HackerHotel/PCB/README.md

# PCB

This repository hosts the board files for the HackerHotel 2019 badge.

This is an EAGLE 8 (?) project. It should be possible to import it in
[KiCad](https://kicad-pcb.org)
