HackerHotel/PCB/assembly/Hackerhotel_BOM.xls

HackerHotel 2019 BOM
Contact: bas@knutselaar.net
Rev 1
Qty per PCB | Type | Device | Value | Package | Parts
1 | Display socket | 68712414022 | 24 pos FPC 0.5mm SMD right angle | 68712414022 | X1
4 | Schottky diode | BAT20JFILM | NSVR0320MW2T1G | SOD-323 | D3, D7, D8, D9
20 | Capacitor | C0603 | 100n | C0603 | C1, C2, C3, C4, C5, C6, C8, C10, C11, C14, C16, C22, C23, C27, C28, C29, C37, C44, C45, C54
15 | Capacitor | C0603 | 1µ | C0603 | C19, C21, C25, C32, C33, C35, C36, C38, C39, C40, C42, C46, C49, C50, C53
11 | Capacitor | C-EUC0805 | 4.7µ / 16V | C0805 | C9, C13, C15, C17, C18, C20, C24, C26, C30, C34, C43
1 | ESD Suppressor | DIODE-SCHOTTKY-PMEG4005EJ | SD05-7 | SOD-323 | D1
1 | Inductor | INDUCTOR1210 | 47µ | L1210 | L1
1 | Battery connector | JST S3B-PH-SM4-TB | JST S3B-PH-SM4-TB | JST-PH3 | X4
1 | Voltage regulator | AP2114H-3.3TRG1 | AP2114H-3.3TRG1 | SOT233-3 | IC2
1 | Red LED | LED0603 | RED | LED-0603 | D5
1 | Yellow LED | LED0603 | Yellow | LED-0603 | D4
1 | Green LED | LED0603 | green | LED-0603 | D6
1 | USB connector | MOLEX-47346-0001 | MOLEX-47346-0001 | MOLEX-47364-0001 | USB1
2 | N-channel MOSFET | MOSFET-NCHANNEL2N7002PW | SI1304 BDL | SOT323 | Q5, Q6
2 | P-channel MOSFET | MOSFET-PCHANNEL |  | SOT23-3 | T1, T2
1 | Touch IC | MPR121QR2 | MPR121QR2 | QFN40P300X300X60-20N | U1
1 | Sound chip | PCM5102A | PCM5102A | TSSOP 20pins | U3
1 | 3.5mm stereo jack | PJ-313D | PJ-313D | PJ-313D | J1
2 | PTC Fuse | PTCSMD | 1A | PTC-1206 | F1, F2
1 | Resistor | R1206 | 0.27Ω 1/4W | R1206 | R30
2 | Resistor | R0603 | 1.2k | R0603 | R29, R35
4 | Resistor | R0603 | 100k | R0603 | R1, R6, R20, R36
11 | Resistor | R0603 | 10k | R0603 | R2, R4, R5, R9, R10, R13, R15, R16, R18, R22, R32
3 | Resistor | R0603 | 1k | R0603 | R3, R12, R14
2 | Resistor | R0603 | 220k | R0603 | R7, R21
1 | Resistor | R0603 | 2.7Ω | R0603 | R19
2 | Resistor | R0603 | 4k7 | R0603 | R23, R24
1 | Resistor | R0603 | 75k 1% | R0603 | R37
2 | Tactile switch | SWITCH-MOMENTARY-2SMD | SWITCH-MOMENTARY-2SMD | TACTILE-SWITCH-SMD | S1, S2
1 | Battery charger IC | TP4056 | TP4056 | SOP-8 | IC4
3 | NPN transistor | TRANSISTOR_NPNMMBT2222A | MMBT2222A | SOT23-3 | Q1, Q3, Q4
Inbound from Sillicon Labs (do not buy!)
1 | USB-Serial IC | CP210X_USB_UART | CP210X_USB_UART | MLP28 | IC1
Optional depending on budget for mounting
1 | CONN HEADER PH TOP 4POS 2MM SMD | B4B-PH-SM4-TB | B4B-PH-SM4-TB | JST_B4B-PH-SM4-TB | P1
6 | SK2812 RGBW pixels | SK6812 | SK6812-RGBW | 5050 | D100, D101, D102, D103, D104, D105
Optional depending on budget, do not mount
1 | IR LED
1 | IR Receiver | TL1838 VS1838B 1838 38Khz
Do not buy/mount
1 | ESP module | ESP32WROVER32 | ESP32WROVER32 | XCVR_ESP32-WROVER-I | U2
