HackerHotel/PCB/hh2019_proto.brd

## EAGLE design hh2019_proto.brd (2018-12-31)

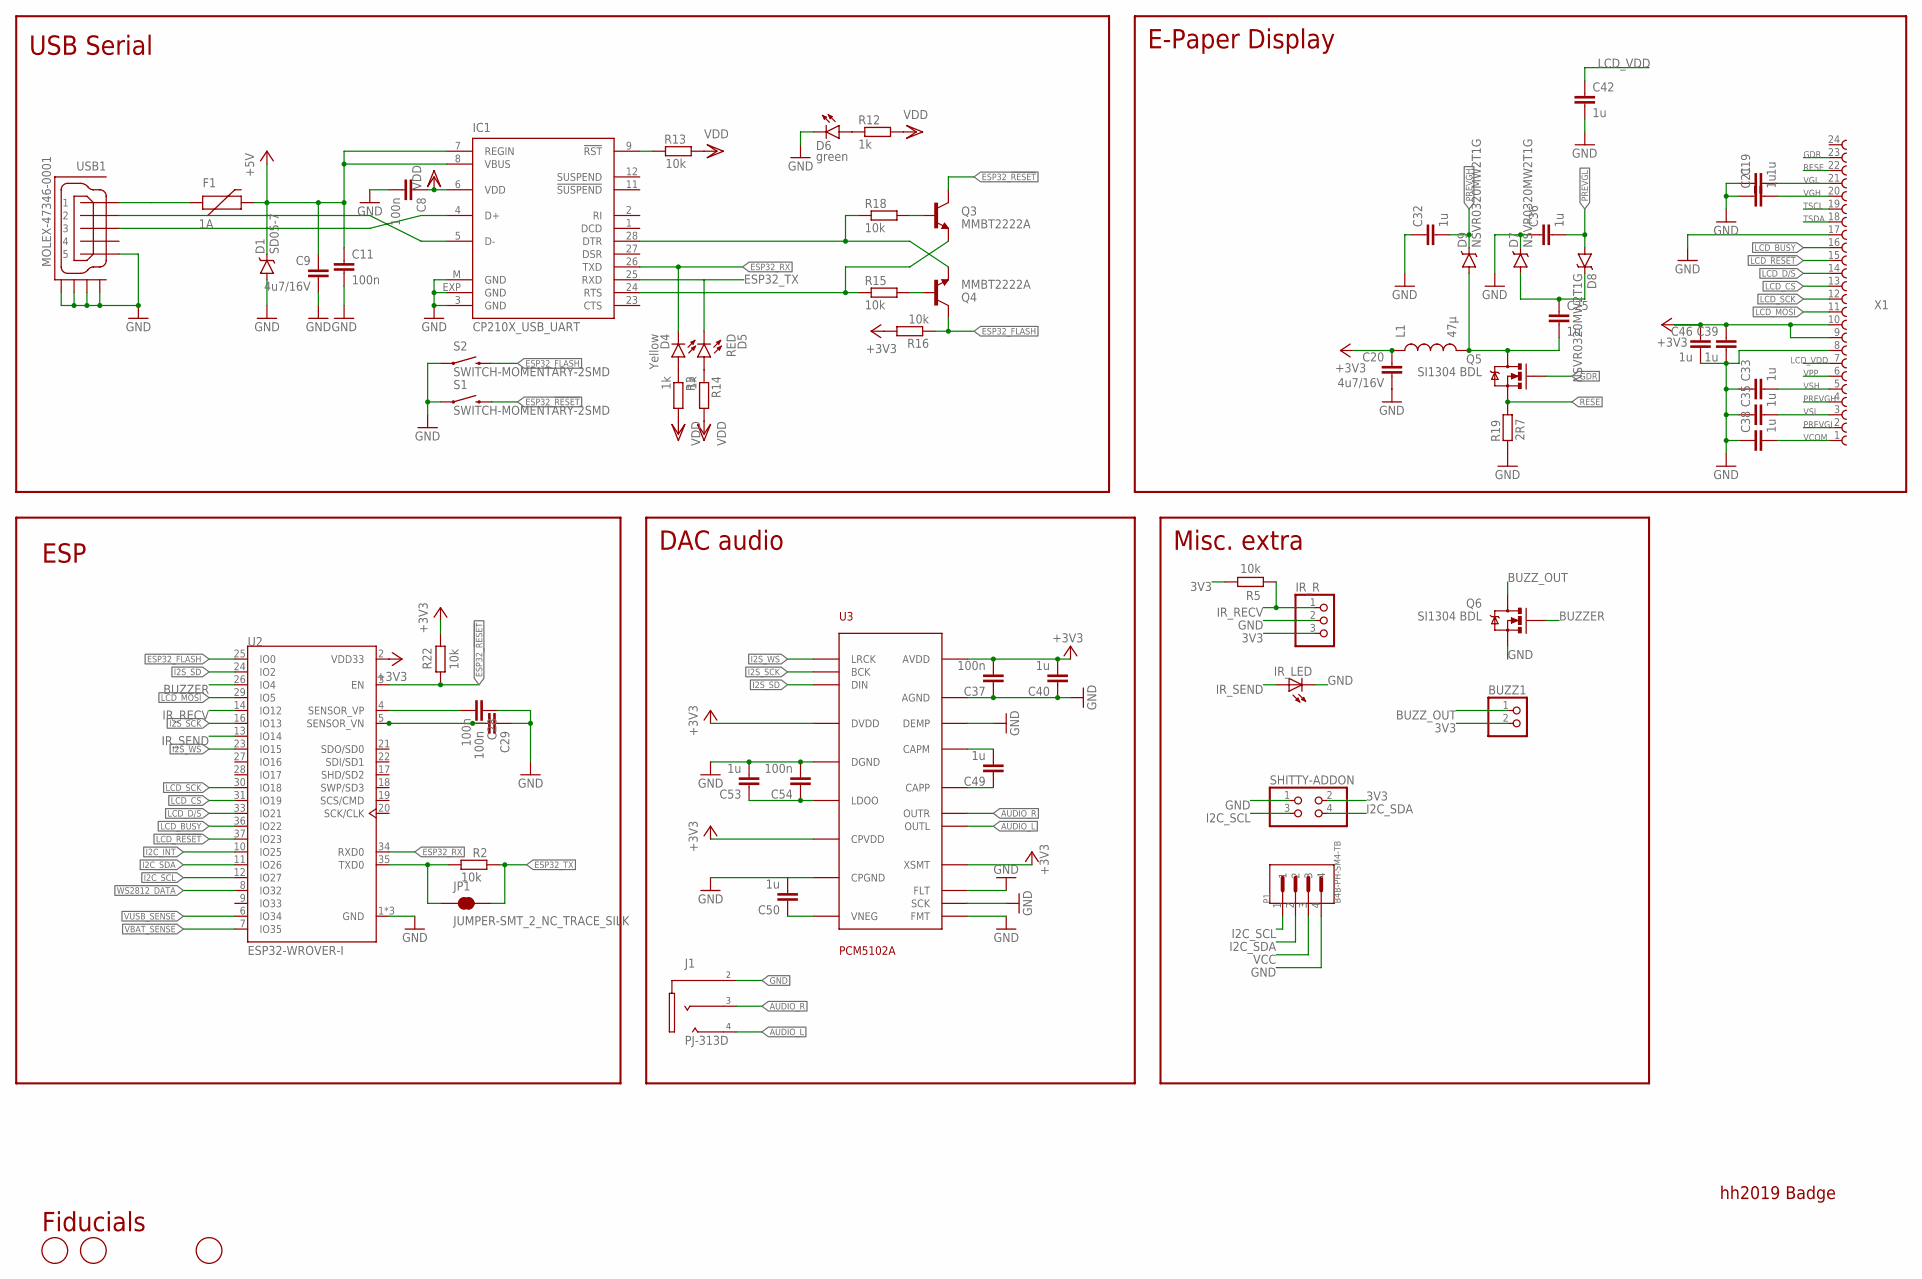
[picture p1: schematic hh2019_proto.sch, sheet 1]

Parts:
BUZZ1: PINHD-1X2; 1X02
C8, C11, C28, C29: 100n; C0603-DASHES; PARTNO GRM188R71H104KA93D
C9, C20: 4u7/16V; C0805; PARTNO GRM21BR61C475KA88K
C19, C21, C25, C32, C33, C35, C36, C38, C39, C42, C46: 1u; C0603-DASHES; PARTNO GRM188R61E105KA12D
C37, C54: 100n; C0603
C40, C49, C50, C53: 1u; C0603
D1: SD05-7; SOD-323; PARTNO SD05-7
D4: Yellow; LED-0603
D5: RED; LED-0603
D6: green; LED-0603
D7, D8, D9: NSVR0320MW2T1G; SOD-323; PARTNO BAT20JFILM
F1: 1A; PTC-1206
FD1, FD4, FD5: FIDUCIAL; FIDUCIAL_1MM; PARTNO NAP
IC1: CP210X_USB_UART; MLP28; PARTNO CP2102-GMR
IR_LED: LED5MM
IR_R: PINHD-1X3; 1X03
J1: PJ-313D
JP1: JUMPER-SMT_2_NC_TRACE_SILK; SMT-JUMPER_2_NC_TRACE_SILK
L1: 47µ; 1210; PARTNO NLCV32T-220K-EF
P1: B4B-PH-SM4-TB; JST_B4B-PH-SM4-TB
Q3, Q4: MMBT2222A; SOT23-3; PARTNO BC817-25,215
Q5, Q6: SI1304 BDL; SOT323; PARTNO SI1308EDL-T1-GE3
R2, R5, R13, R15, R16, R18, R22: 10k; R0603-DASHES; PARTNO ERJ-3GEYJ103V
R3, R12, R14: 1k; R0603-DASHES; PARTNO ERJ-3GEYJ102V
R19: 2R7; R0603-DASHES; PARTNO ERJ-3GEYJ5R1V
S1, S2: SWITCH-MOMENTARY-2SMD; TACTILE-SWITCH-SMD; PARTNO SKQGABE010
SHITTY-ADDON: PINHD-2X2; 2X02
U2: ESP32-WROVER-I; XCVR_ESP32-WROVER-I
U3: PCM5102A
USB1: MOLEX-47346-0001; MOLEX-47364-0001; PARTNO 10118192-0001LF
X1: 68712414022; PARTNO 68712414022

Connections:
3V3: BUZZ1.2, C20.1, C37.2, C39.1, C40.2, C46.1, IR_R.3, L1.1, R5.1, R16.2, R22.1, SHITTY-ADDON.2, U2.2 (VDD33), U3.P$1 (CPVDD), U3.P$8 (AVDD), U3.P$17 (XSMT), U3.P$20 (DVDD), X1.9, X1.10; also elsewhere on the board
+5V: C9.1, C11.1, D1.C, F1.2, IC1.7 (REGIN), IC1.8 (VBUS); also elsewhere on the board
AUDIO_L: J1.4_1 (4), J1.4_2 (4), U3.P$6 (OUTL)
AUDIO_R: J1.3_1 (3), J1.3_2 (3), U3.P$7 (OUTR)
BUZZER: Q6.1 (G), U2.26 (IO4)
BUZZ_OUT: BUZZ1.1, Q6.3 (D)
CAPM: C49.2, U3.P$4 (CAPM)
CAPP: C49.1, U3.P$2 (CAPP)
ESP32_!RESET: Q3.3 (C), R22.2, S1.3 (2), U2.3 (EN)
ESP32_FLASH: Q4.3 (C), R16.1, S2.3 (2), U2.25 (IO0)
ESP32_RX: D4.C, IC1.26 (TXD), U2.34 (RXD0)
ESP32_TX: D5.C, IC1.25 (RXD), JP1.2, R2.1
ESP32_TX_PRE: JP1.1, R2.2, U2.35 (TXD0)
GDR: Q5.1 (G), X1.23
GND: C8.2, C9.2, C11.2, C19.1, C20.2, C21.1, C28.1, C29.1, C32.1, C33.1, C35.1, C36.1, C37.1, C38.1, C39.2, C40.1, C42.2, C46.2, C50.2, C53.2, C54.2, D1.A, D6.C, D7.C, IC1.3 (GND), IC1.EXP (GND), IC1.M (GND), IR_LED.K (C), IR_R.2, J1.2_1 (2), J1.2_2 (2), P1.4, Q6.2 (S), R19.2, S1.1, S2.1, SHITTY-ADDON.1, U2.1 (GND), U2.15 (GND), U2.38 (GND), U3.P$3 (CPGND), U3.P$9 (AGND), U3.P$10 (DEMP), U3.P$11 (FLT), U3.P$12 (SCK), U3.P$16 (FMT), U3.P$19 (DGND), USB1.5, USB1.GND1, USB1.GND2, USB1.GND3, USB1.GND4, X1.8, X1.17; also elsewhere on the board
I2C_INT: U2.10 (IO25); also elsewhere on the board
I2C_SCL: P1.1, SHITTY-ADDON.3, U2.12 (IO27); also elsewhere on the board
I2C_SDA: P1.2, SHITTY-ADDON.4, U2.11 (IO26); also elsewhere on the board
I2S_SCK: U2.16 (IO13), U3.P$13 (BCK)
I2S_SD: U2.24 (IO2), U3.P$14 (DIN)
I2S_WS: U2.23 (IO15), U3.P$15 (LRCK)
IR_RECV: IR_R.1, R5.2, U2.14 (IO12)
IR_SEND: IR_LED.A, U2.13 (IO14)
LCD_!RESET: U2.37 (IO23), X1.15
LCD_BUSY: U2.36 (IO22), X1.16
LCD_CS: U2.31 (IO19), X1.13
LCD_D/!S: U2.33 (IO21), X1.14
LCD_MOSI: U2.29 (IO5), X1.11
LCD_SCK: U2.30 (IO18), X1.12
LCD_VDD: C42.1, X1.7
LDO0: C53.1, C54.1, U3.P$18 (LDOO)
unnamed: IC1.24 (RTS), Q3.2 (E), R15.1
unnamed: IC1.28 (DTR), Q4.2 (E), R18.1
unnamed: Q4.1 (B), R15.2
unnamed: Q3.1 (B), R18.2
unnamed: C25.1, D7.A, D8.C
unnamed: C25.2, D9.A, L1.2, Q5.3 (D)
unnamed: D6.A, R12.1
unnamed: D4.A, R3.1
unnamed: D5.A, R14.1
unnamed: F1.1, USB1.1
unnamed: C28.2, U2.4 (SENSOR_VP)
unnamed: C29.2, U2.5 (SENSOR_VN)
PREVGH: C32.2, D9.C, X1.4
PREVGL: C36.2, D8.A, X1.2
RESE: Q5.2 (S), R19.1, X1.22
RST: IC1.9 (!RST), R13.2
TSCL: X1.19
TSDA: X1.18
USB_DN_CON: IC1.5 (D-), USB1.2
USB_DP_CON: IC1.4 (D+), USB1.3
VBAT_SENSE: U2.7 (IO35); also elsewhere on the board
VCC: P1.3; also elsewhere on the board
VCOM: C38.2, X1.1
VDD: C8.1, IC1.6 (VDD), R3.2, R12.2, R13.1, R14.2
VGH: C21.2, X1.20
VGL: C19.2, X1.21
VNEG: C50.1, U3.P$5 (VNEG)
VPP: X1.6
VSH: C33.2, X1.5
VSL: C35.2, X1.3
VUSB_SENSE: U2.6 (IO34); also elsewhere on the board
WS2812_DATA: U2.8 (IO32); also elsewhere on the board

Notes on the sheet:
USB Serial
E-Paper Display
ESP
Fiducials
hh2019 Badge
DAC audio
Misc. extra

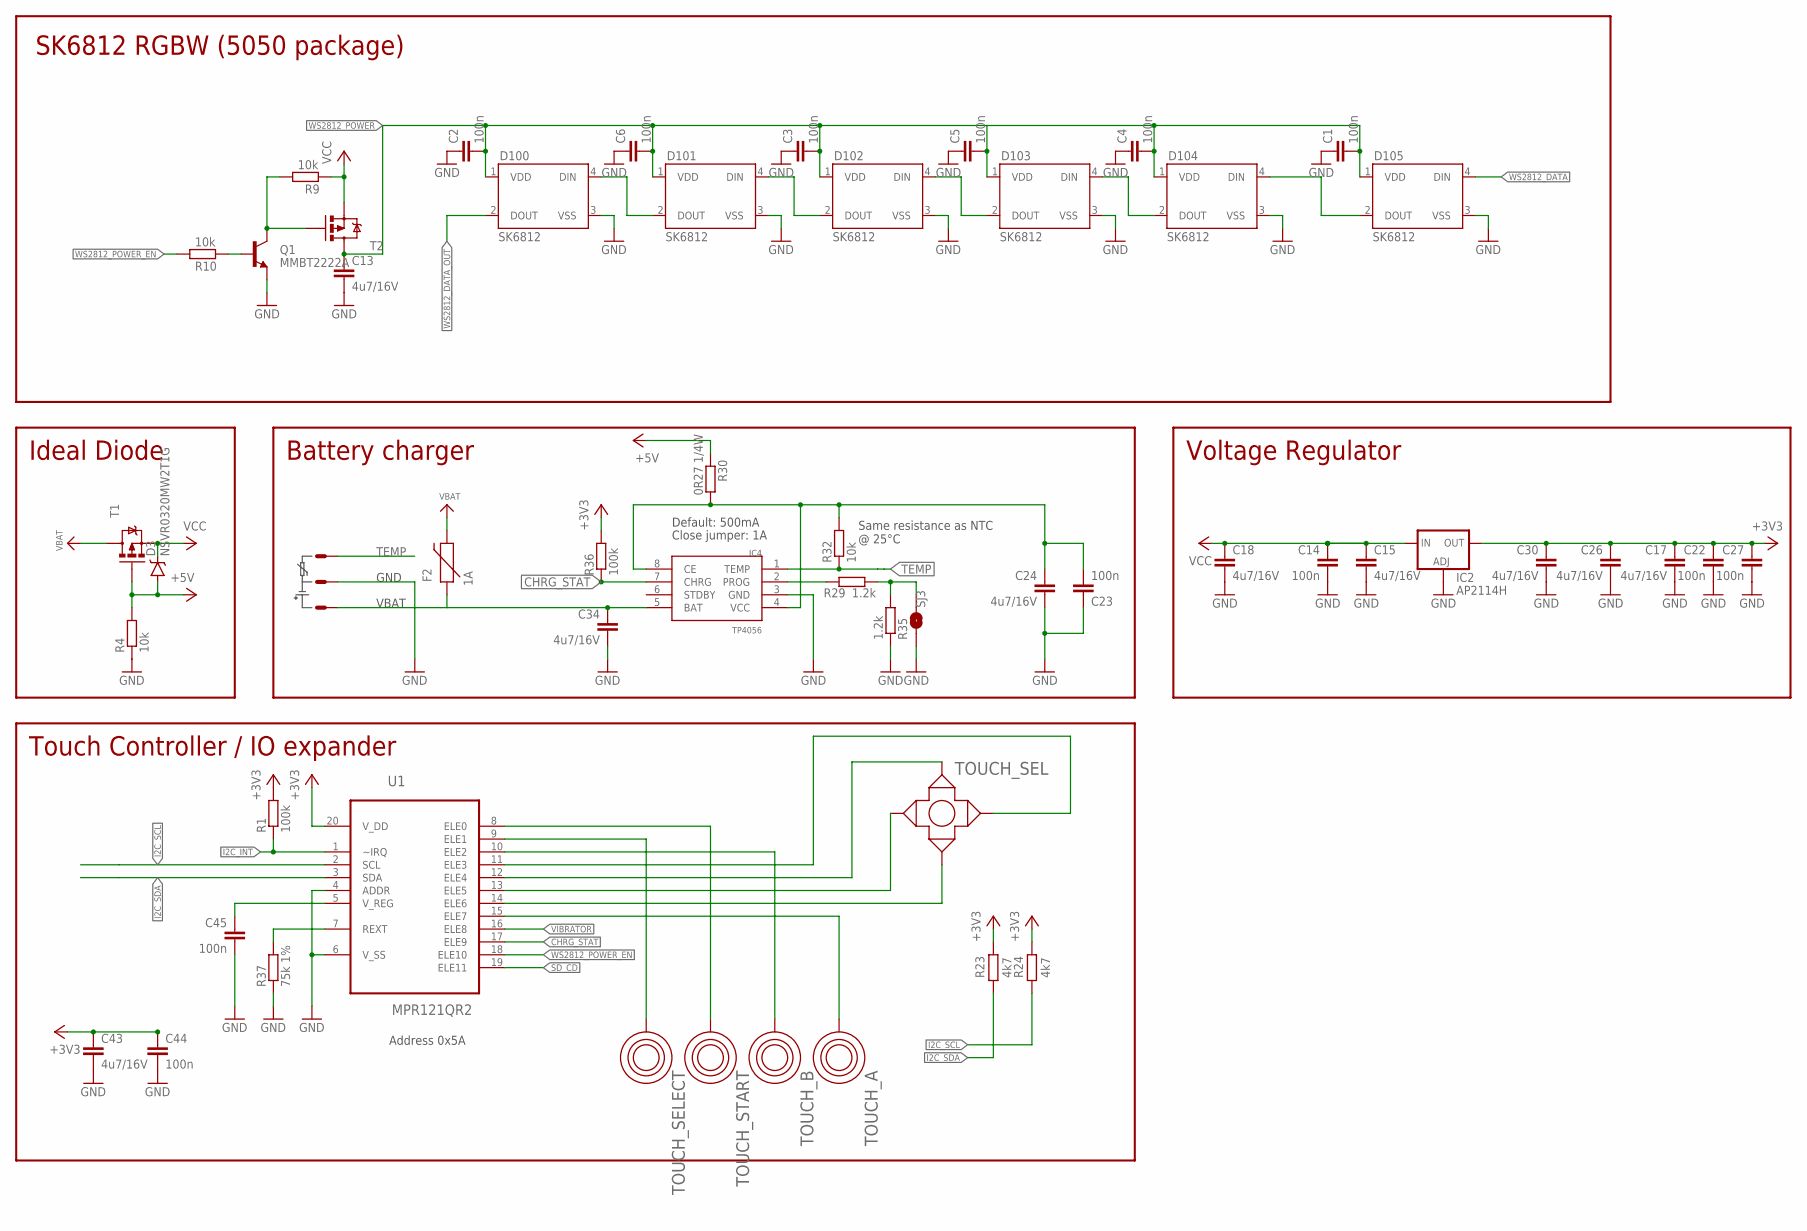
[picture p2: schematic hh2019_proto.sch, sheet 2]

Parts:
C1, C2, C3, C4, C5, C6, C14, C22, C23, C27, C44, C45: 100n; C0603-DASHES; PARTNO GRM188R71H104KA93D
C13, C15, C17, C18, C24, C26, C30, C34, C43: 4u7/16V; C0805; PARTNO GRM21BR61C475KA88K
D3: NSVR0320MW2T1G; SOD-323; PARTNO BAT20JFILM
D100, D101, D102, D103, D104, D105: SK6812; WS2812B; PARTNO SK6812
F2: 1A; PTC-1206
IC2: AP2114H; SOT223; PARTNO AP7215-33YG-13
IC4: TP4056; SOP-8
Q1: MMBT2222A; SOT23-3; PARTNO BC817-25,215
R1, R36: 100k; R0603-DASHES; PARTNO ERJ-3GEYJ104V
R4, R9, R10: 10k; R0603-DASHES; PARTNO ERJ-3GEYJ103V
R23, R24: 4k7; R0603-DASHES; PARTNO ERJ-3GEYJ103V
R29, R35: 1.2k; R0603-DASHES; PARTNO ERJ-3GEYJ222V
R30: 0R27 1/4W; R1206; PARTNO ERJ-3GEYJ154V
R32: 10k; R0603-DASHES; PARTNO ERJ-3GEYJ154V
R37: 75k 1%; R0603-DASHES; PARTNO ERJ-3GEYJ104V
SJ3: JUMPER-PAD-2-NOYES_SILK; PAD-JUMPER-2-NO_YES_SILK; PARTNO NAP
T1, T2: MOSFET-PCHANNEL; SOT23-3
TOUCH_A: TOUCHROUND; TOUCH_BUTTON; PARTNO NAP
TOUCH_B: TOUCHROUND; TOUCH_BUTTON; PARTNO NAP
TOUCH_SEL: TOUCH_CROSS; PARTNO NAP
TOUCH_SELECT: TOUCHSELECT; TOUCH_SELECT
TOUCH_START: TOUCHSELECT; TOUCH_SELECT
U1: MPR121QR2; QFN40P300X300X60-20N
X4: JST-PH3

Connections:
3V3: C17.1, C22.1, C26.1, C27.1, C30.1, C43.1, C44.1, IC2.4 (OUT), R1.2, R23.1, R24.1, R36.2, U1.20 (V_DD); also elsewhere on the board
+5V: D3.A, R4.2, R30.1, T1.1 (G); also elsewhere on the board
BAT: C34.1, F2.1, IC4.5 (BAT), X4.3
CE: C23.2, C24.1, IC4.4 (VCC), IC4.8 (CE), R30.2, R32.2
CHRG_STAT: IC4.7 (CHRG), R36.1, U1.17 (ELE9)
ELE0: TOUCH_START.P$1, U1.8 (ELE0)
ELE1: TOUCH_SELECT.P$1, U1.9 (ELE1)
ELE2: TOUCH_B.P$1, U1.10 (ELE2)
ELE3: TOUCH_SEL.R (RIGHT), U1.11 (ELE3)
ELE4: TOUCH_SEL.UP, U1.12 (ELE4)
ELE5: TOUCH_SEL.L (LEFT), U1.13 (ELE5)
ELE6: TOUCH_SEL.D (DOWN), U1.14 (ELE6)
ELE7: TOUCH_A.P$1, U1.15 (ELE7)
GND: C1.1, C2.1, C3.1, C4.1, C5.1, C6.1, C13.2, C14.2, C15.2, C17.2, C18.2, C22.2, C23.1, C24.2, C26.2, C27.2, C30.2, C34.2, C43.2, C44.2, C45.2, D100.3 (VSS), D101.3 (VSS), D102.3 (VSS), D103.3 (VSS), D104.3 (VSS), D105.3 (VSS), IC2.1 (ADJ), IC4.3 (GND), Q1.2 (E), R4.1, R35.2, R37.1, SJ3.1, U1.4 (ADDR), U1.6 (V_SS), X4.2; also elsewhere on the board
I2C_INT: R1.1, U1.1 (~IRQ); also elsewhere on the board
I2C_SCL: R24.2, U1.2 (SCL); also elsewhere on the board
I2C_SDA: R23.2, U1.3 (SDA); also elsewhere on the board
unnamed: D100.4 (DIN), D101.2 (DOUT)
unnamed: D103.4 (DIN), D104.2 (DOUT)
unnamed: D104.4 (DIN), D105.2 (DOUT)
unnamed: R29.2, R35.1, SJ3.2
unnamed: D101.4 (DIN), D102.2 (DOUT)
unnamed: C45.1, U1.5 (V_REG)
unnamed: R37.2, U1.7 (REXT)
unnamed: D102.4 (DIN), D103.2 (DOUT)
unnamed: Q1.1 (B), R10.2
unnamed: Q1.3 (C), R9.1, T2.1 (G)
PROG: IC4.2 (PROG), R29.1
SD_CD: U1.19 (ELE11)
TEMP: IC4.1 (TEMP), R32.1, X4.1
VBAT: F2.2, T1.3 (D); also elsewhere on the board
VCC: C14.1, C15.1, C18.1, D3.C, IC2.3 (IN), R9.2, T1.2 (S), T2.2 (S); also elsewhere on the board
VIBRATOR: U1.16 (ELE8)
WS2812_DATA: D105.4 (DIN); also elsewhere on the board
WS2812_DATA_OUT: D100.2 (DOUT)
WS2812_POWER: C1.2, C2.2, C3.2, C4.2, C5.2, C6.2, C13.1, D100.1 (VDD), D101.1 (VDD), D102.1 (VDD), D103.1 (VDD), D104.1 (VDD), D105.1 (VDD), T2.3 (D)
WS2812_POWER_EN: R10.1, U1.18 (ELE10)

Notes on the sheet:
Voltage Regulator
Battery charger
Ideal Diode
Default: 500mA
Close jumper: 1A
GND
VBAT
Same resistance as NTC @ 25°C
SK6812 RGBW (5050 package)
Touch Controller / IO expander
Address 0x5A

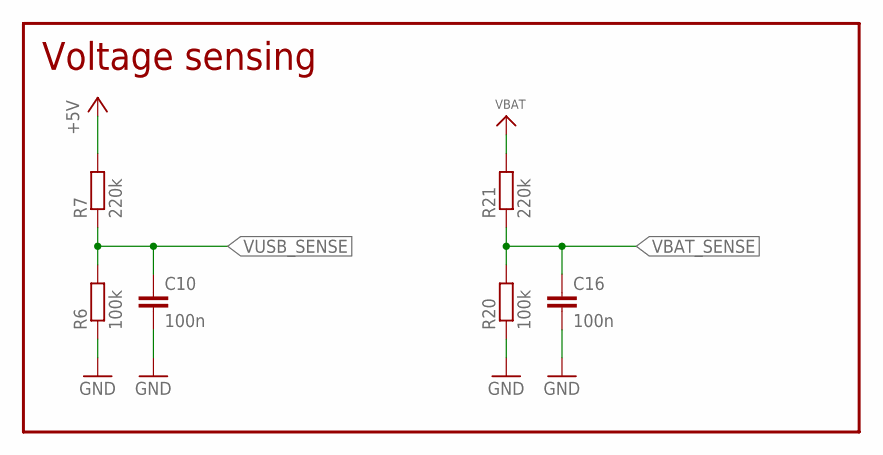
[picture p3: schematic hh2019_proto.sch, sheet 3]

Parts:
C10, C16: 100n; C0603-DASHES; PARTNO GRM188R71H104KA93D
R6, R20: 100k; R0603-DASHES; PARTNO ERJ-3GEYJ104V
R7, R21: 220k; R0603-DASHES; PARTNO ERJ-3GEYJ224V

Connections:
+5V: R7.2; also elsewhere on the board
GND: C10.2, C16.2, R6.1, R20.1; also elsewhere on the board
VBAT: R21.2; also elsewhere on the board
VBAT_SENSE: C16.1, R20.2, R21.1; also elsewhere on the board
VUSB_SENSE: C10.1, R6.2, R7.1; also elsewhere on the board

Notes on the sheet:
Voltage sensing

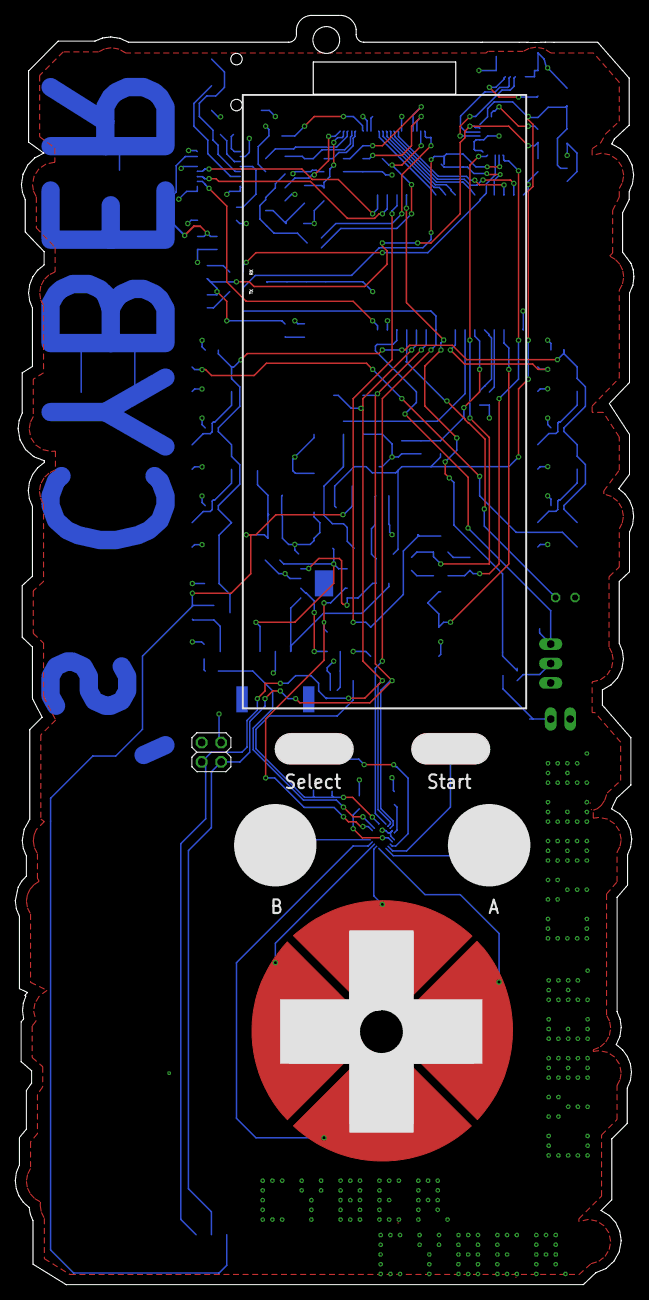
[picture p4: board hh2019_proto.brd from above]

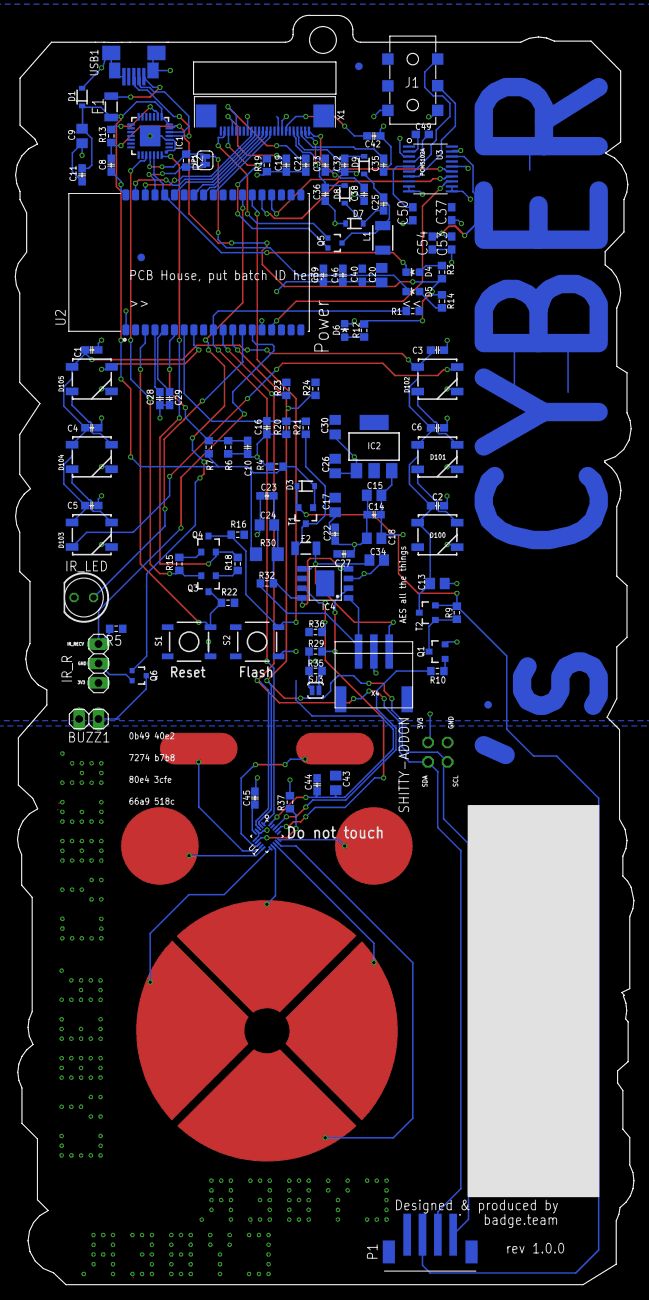
[picture p5: board hh2019_proto.brd from below]

Board: 2 copper layers, 80.8 x 165.7 mm, 124 parts (118 on the bottom side), 86 nets.
