HackerHotel/PCB/(threads)

Thread 3 (2018-12-02):

Touch layout

sebastius, 2018-12-02:
er loopt van de linker select knop een trace over het pcb naar de andere select knop. Dit geeft storing als je de rechter indrukt.

de directional pad onder en rechts storen elkaar omdat er geen groundplane tussen de traces zit (en ze zijn enorm lang)

tjclement, 2018-12-20:
Naar waarschijnlijkheid gefixed, alhoewel er _tussen_ de traces geen groundplane kan, omdat we dan volgens de specs juist storing gaan krijgen

sebastius, 2018-12-20:
Ok, dat zijn weer details die ik niet weet :)

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

Closed 2018-12-20.

Thread 4 (2018-12-02):

Ergonomie/formfactor

sebastius, 2018-12-02:
- PCB moet onderaan verder doorgaan (dus langer worden onder de directional pad)
- Select buttons mogen iets dichter op scherm en verder uit elkaar
-bord mag smaller worden
-LEDs onderop blijkt gek genoeg best leuk en geeft minder oogkanker
-ESP Wrover antenne moet aan de rand van het pcb gaan komen
-Audioconnector en USB zitten te dicht op displayconnector, display aansluiten is irritant.

tjclement, 2018-12-20:
Tijdelijk brickdesign voldoet aan bovenstaande. De antenne zit niet direct aan de rand van de PCB, maar heeft een restrict fill zone rondom de antenne tot aan de rand, waardoor er geen koper in de buurt zit. Er zal dus geen zendvermogen verloren gaan

Closed 2018-12-20.

Thread 7 (2019-01-28):

Miss alignment in gerber layers.

opeRaptor, 2019-01-28:
I noticed some miss aligned layers in the gerber.

This might be due to a non regenerated copper fill?

It seem to be only aesthetic traces but worth a double check.

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

annejan, 2019-01-28:
This is by-design :)

opeRaptor, 2019-01-28:
Good to hear, I wanted to point it out as I wasnt sure.

Easily done and I would have appreciated it if it had been my design.

Looking forward to the even!

Closed 2019-01-28.
