HackerHotel/PCB/(commit log)

2018-11-04 Initialised fork from SHA2017 for HackerHotel 2019
    [hh2019_proto_rev1_0_0.brd, hh2019_proto_rev1_0_0.sch, hh2019_proto_rev1_0_0_bom.ods, sha2017_proto_rev1_0_0.brd, sha2017_proto_rev1_0_0.sch, sha2017_rev0_0_1_dev.brd, sha2017_rev0_0_1_dev.sch, sha2017_rev0_0_2_dev.brd]
2018-11-12 Added DAC + 3.5mm socket, working on board
    [hh2019_proto.brd, hh2019_proto.sch, hh2019_proto_rev1_0_0_bom.ods]
2018-11-12 Fixed severed F/B annotation
    [hh2019_proto.brd]
2018-11-12 Fixed net names on DAC
    [hh2019_proto.brd, hh2019_proto.sch]
2018-11-13 Fixed ESP32 net labels, removed SD card components, working on layout
    [hh2019_proto.brd, hh2019_proto.sch]
2018-11-13 Cleaned up old schematic and board
    [hh2019_proto_rev1_0_0.brd, hh2019_proto_rev1_0_0.sch]
2018-11-13 Removed some bypass caps from DAC
    [hh2019_proto.brd, hh2019_proto.sch]
2018-11-13 Prepping layout
    [hh2019_proto.brd, hh2019_proto.sch]
2018-11-13 Added net names for touch controller pins (will remap touch buttons for easy routing later)
    [hh2019_proto.brd, hh2019_proto.sch]
2018-11-14 Collected components in groups in board design
    [hh2019_proto.brd]
2018-11-14 Reassigned touch controller pins for easier layouting, got proper main component placement on board
    [hh2019_proto.brd, hh2019_proto.sch]
2018-11-14 Placed major components, working on passives
    [hh2019_proto.brd, hh2019_proto.sch]
2018-11-15 Routing tracks
    [hh2019_proto.brd]
2018-11-15 Added most non-bypass passives
    [hh2019_proto.brd, hh2019_proto.sch]
2018-11-15 All but the last handful passives placed and routed
    [hh2019_proto.brd, hh2019_proto.sch]
2018-11-15 All components placed
    [hh2019_proto.brd]
2018-11-15 Fixed DRC errors
    [hh2019_proto.brd]
2018-11-16 Shrunk PCB dimensions, added version and credits
    [hh2019_proto.brd]
2018-12-20 Added missing DAC connections. Fixes #1
    [hh2019_proto.brd, hh2019_proto.sch]
2018-12-20 Fixed floating DAC pins being unconnected
    [hh2019_proto.brd, hh2019_proto.sch]
2018-12-20 Increased touch trace robustness, and added proper passthrough of back groundplane
    [hh2019_proto.brd]
2018-12-20 Made board smaller, placed caps closer to touch controller, increased free space around display connector, implemented dull brick PCB design. Fixes issues #2 #3 #4.
    [hh2019_proto.brd]
2018-12-28 Finished PCB design. Added Shitty AddOn, IR, buzzer
    [hh2019_proto.brd, hh2019_proto.sch]
2018-12-29 Added moar cybar
    [hh2019_proto.brd]
2018-12-29 Added Renze's superfluous Grove connector
    [hh2019_proto.brd, hh2019_proto.sch]
2018-12-31 Finished design, exported BOM and centroid files, and created gerbers
    [hh2019_proto.brd, hh2019_proto.sch, hh2019_proto_BOM.csv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]
2020-10-05 Document that you can open this in KiCad
