HackerHotel/PCB/(notices)

Notices in the files:
parts and their libraries:
SparkFun-DigitalIC: Licensing: Creative Commons ShareAlike 4.0 International - https://creativecommons.org/licenses/by-sa/4.0
EAGLE-FPC_CONNECTOR_AND_FFC_CAB-rev1: Copyright: Würth Elektronik
